azeedanhilmiya-eng/mine-safety-system/docs/README.md

# Project documents

## Project plans and experiments

- `project/矿山安全监测项目_华北五省比赛创新实施方案.docx` — competition implementation plan.
- `project/矿山安全监测系统_轻量离线语音识别与LoRa通信小步创新方案.docx` — offline voice and LoRa design proposal.
- `project/矿山安全监测系统_双节点语音与LoRa通信实施方案.docx` — dual-node implementation plan.
- `project/实验方案_离线语音与LoRa矿山安全监测.md` — experiment methods, target metrics, and data-recording templates.

The plans describe proposed work. Target metrics and unfilled schedules are not test results.

## Hardware files

- `hardware/最新方案_硬件清单.md` and `hardware/最新方案_硬件采购与PCB核对清单.xlsx` — component selection and PCB compatibility notes.
- `hardware/Gerber_safety-system_PCB_safety-system_2026-04-22(3).zip` — PCB manufacturing files.

For firmware layout and build instructions, see [`../firmware/README.md`](../firmware/README.md).
