azeedanhilmiya-eng/mine-safety-system/docs/project/矿山安全监测项目_华北五省比赛创新实施方案.docx

矿山安全监测项目
华北五省比赛创新实施方案

在现有系统基础上增加轻量趋势预警与可靠通信

参赛方向

本科组 方向三 具身智能与物理 AI

2026 年 9 月

# 一 总体结论

本方案坚持少改硬件、少加功能、先做完整。保留现有两套井下节点、地面网关、LoRa、OLED、短信和 App，只完成一个小创新和两项必要优化：在地面网关增加轻量趋势预警，统一设备与 App 数据字段，为 LoRa 增加序号和一次重传。完成后即可形成适合本科课程设计的监测、预警、告警和展示闭环。

# 二 赛道定位与比赛硬要求

- 参赛方向：本科组方向三“具身智能与物理 AI”。现有 ESP32-S3、LoRa、传感器、声光告警和实体终端与该方向匹配度较高。
- 作品须提供可运行的完整软硬件系统、详细设计文档、源代码和实物作品，并准备现场演示。
- 联网功能应按大赛要求通过公网正常访问；本地离线链路是增强系统鲁棒性和现场演示可靠性的设计，不替代公网访问要求。
- 作品必须原创。AI 辅助内容、第三方开源代码、模型名称和版本、AI 编写代码比例均需如实说明。
- 本科组每队 2—5 名学生，每人限参加一个团队；每队指导教师不超过 2 人。

# 三 建议作品名称

矿安智联 基于 ESP32 S3 和 LoRa 的端侧多灾害融合预警系统

# 四 现有项目基础

现有项目已经形成两套井下采集节点、一套地面网关、LoRa 传输、OLED 与声光报警、SIM800L 短信、Firebase、Web 看板和 Flutter 应用，主体功能已经足够。比赛版不重新设计 PCB，不增加摄像头、机械臂或大量传感器，也不重做整套 App；只修通现有链路，并加入一个能够现场说明、现场演示和现场测量的小创新。

# 五 精简后的改造重点

当前情况 | 比赛版整改
固定 ADC 阈值判断 | 增加基于滑动均值和变化斜率的轻量趋势预警，硬阈值继续负责正式告警。
原始 ADC 值被标为 ppm | 完成标准标定后才能使用 ppm；否则统一称为相对浓度指数。
固件只发送 flags，App 读取 hazard_ch4 等字段 | 统一设备报文、数据库字段和 App 数据模型。
固件写 RTDB，部分程序读取 Firestore | 比赛版统一使用 RTDB，暂不迁移数据库。
实物 2 个节点，界面固定显示 3 个 | 节点数量配置化，所有界面和演示以真实硬件为准。
仍有国外坐标、电话和英文场景 | 全部替换为中国矿山试验场景和中文应急流程。
多份固件引脚定义不一致 | 按手中实物确定一份可用引脚表和主固件，其余副本暂不使用。

# 六 我们的小步创新方案

我们保留原有系统结构，只在现有数据链路上增加容易完成、容易解释的功能。核心创新是轻量趋势预警，两项配套优化是数据统一和 LoRa 简单重传。三项工作互相支撑，但都不需要新增复杂硬件。

改造项 | 具体做法 | 最低完成标准
小创新 轻量趋势预警 | 网关保存最近 10 次数据，计算滑动均值和变化斜率；用逻辑回归或简单评分输出低、中、高风险 | 能比硬阈值提前数秒显示风险上升，且不会替代硬阈值告警
优化一 数据统一 | 确定一套 JSON 字段，固件、RTDB、Web 和 Flutter 使用相同名称 | 两个真实节点的数据和告警能在 App 中正确显示
优化二 可靠传输 | 报文增加节点 ID、序号和校验；告警包未收到 ACK 时重发一次 | 演示中能显示包序号，丢包后可完成一次补发
展示优化 | 界面中文化，只显示两个节点、风险等级、通信状态和最近告警 | 五分钟内能完整演示正常监测、趋势预警和阈值告警
实验记录 | 用电位器或历史数据回放模拟缓慢上升和突增 | 完成阈值方案与趋势预警方案的简单对比表

- 必须完成：唯一主固件、统一字段、趋势预警、一次重传、中文界面和演示视频。
- 时间充足再做：本地网页、短信通知优化和更长时间稳定性测试。
- 本轮不做：新 PCB、摄像头、机械结构、复杂神经网络、多模型对比和真实危险气体实验。

# 七 目标系统架构

井下采集节点 → LoRa 传输 → 地面网关趋势预警 → Firebase 与现有 App

## 1 硬件与固件基线

- 保留 2 个 ESP32-S3 井下节点、SX1278 433 MHz LoRa、MQ-4、MQ-7、水浸传感器、地面 ESP32-S3、OLED、蜂鸣器和 SIM800L。
- 按真实 PCB 核对 ESP32-S3、LoRa、SIM800L、OLED 和告警器件引脚，只保留一份可编译主固件。
- 不新增传感器，不重画 PCB；SIM800L 若供电不稳定，可在比赛演示中降为可选功能。

## 2 轻量趋势预警

地面网关保存每个节点最近 10 次采样，计算 MQ-4、MQ-7 和水浸数据的滑动均值与变化斜率。首选逻辑回归；如果训练与部署来不及，可使用归一化加权评分实现同样的低、中、高风险输出，并如实说明算法。

- 缓慢上升时先显示“趋势风险”，达到原有阈值后再触发蜂鸣器和正式告警。
- 输入只使用已有传感器数据，不做图像识别、不做复杂神经网络，也不要求在每个井下节点重复部署。
- 课程设计重点是把采样、计算、显示和告警流程讲清楚，并通过几组安全故障注入证明趋势功能有效。

## 3 简化的可靠通信

- 报文保留节点 ID、序号、传感器值、风险等级和告警位；沿用现有 LoRa 参数。
- 普通数据定时发送，告警数据立即发送；告警包未收到 ACK 时只重发一次，避免实现复杂状态机。
- 地面网关继续同步 Firebase 和现有 App；断网时 OLED 与本地声光告警仍可工作。

# 八 数据采集和实验方案

本作品为教学与竞赛原型，未经矿用防爆、本安及计量认证，不用于真实井下安全生产。不得在宿舍或非专业场所使用危险浓度甲烷、一氧化碳开展测试。数据应由正常实测和安全故障注入两部分组成，并对模拟数据明确标注。

1. 正常数据：每个节点连续记录 30 分钟，覆盖传感器预热和稳定阶段。

2. 趋势数据：使用电位器、DAC 或历史数据回放，分别模拟缓慢上升、快速上升和恢复正常。

3. 每类场景重复 5 次，记录趋势提示时间、阈值告警时间和误提示次数，整理成一张对比表。

4. MQ 传感器未经标准气体标定时只报告相对浓度指数，不使用 ppm；不开展真实危险气体实验。

# 九 必须报告的指标

类别 | 指标 | 建议验收目标
趋势预警 | 提前量、正确提示次数、误提示次数 | 每类场景重复 5 次，结果如实报告
对比 | 固定阈值与趋势预警 | 展示缓慢上升场景中的平均提前量
端侧 | 单次计算时间、Flash、RAM | 不影响原有采样和通信
通信 | 接收率、一次重传成功率 | 两个节点各发送 300 包，接收率目标不低于 95%
告警 | 传感器输入变化到本地声光告警 | 定义起止时间与测试设备，目标小于 1 秒
稳定性 | 连续运行与断电重启 | 连续运行 4 小时并完成 3 次断电恢复

# 十 现场演示闭环

1. 展示两个真实节点在线、实时数据和通信质量。

2. 通过安全故障注入模拟数据缓慢上升，展示趋势风险由低变为中、高。

3. 继续升高输入，触发硬阈值声光告警，证明安全兜底。

4. 展示 LoRa 包序号和一次重传结果，再在 App 中查看同一节点的记录。

5. 用一张对比表说明趋势提示相对硬阈值告警的平均提前时间。

# 十一 推进时间表

日期 | 主要任务 | 阶段产物
9 月 7—10 日 | 核对引脚并确定唯一主固件，跑通双节点采样、LoRa、OLED 和硬阈值告警 | 引脚表、可编译固件、基线视频
9 月 11—16 日 | 统一 JSON、RTDB 和 App 字段，界面只显示两个真实节点 | 字段表、端到端数据截图
9 月 17—21 日 | 实现 10 点滑动均值、变化斜率和三级风险；增加包序号与一次重传 | 趋势预警代码、重传日志
9 月 22—27 日 | 每类场景重复 5 次，完成简单对比；中文化并准备报名 | 对比表、演示版；9 月 28 日前报名
9 月 28—10 月 2 日 | 完成 300 包通信测试、4 小时运行和 3 次断电恢复 | 通信与稳定性记录
10 月 3—6 日 | 使用官方模板整理文档、截图和视频，反复练习五分钟演示 | PDF、MP4、3 张截图
10 月 7 日 | 冻结代码、APK、PDF 和视频，模拟上传 | 最终提交包
10 月 8—10 日 | 正式提交并核对平台状态 | 提交回执和本地备份

# 十二 团队分工建议

角色 | 主要职责
嵌入式负责人 | 统一井下节点与网关固件，实现趋势计算、包序号和一次重传
硬件与测试负责人 | 核对引脚、传感器预热、故障注入、通信和稳定性测试
数据负责人 | 整理场景数据，计算趋势提示提前量和误提示次数
应用与材料负责人 | 统一 RTDB 与 Flutter 字段，完成中文化、文档、截图和视频

# 十三 最终提交清单

- 作品简介：3 张核心功能截图，每张不超过 1 MB；中文简介不超过 400 字。
- 软件创意设计文档：使用大赛官网模板，以 PDF 提交，包含需求、概要设计、详细设计、操作步骤、测试方法和结果。
- 完整源代码：标明团队原创、第三方开源和 AI 辅助部分，附编译与复现说明。
- Android 安装包：Flutter 跨平台作品按照 Android 项目要求提交 APK。
- 演示视频：MP4，不超过 5 分钟、150 MB。
- 现场实物：两个井下节点、地面网关、电源、手机或电脑、本地演示数据、备用线材和备用固件。

# 十四 五分钟视频结构

时间 | 内容
0:00—0:25 | 矿山安全痛点、目标用户和项目结论
0:25—0:55 | 完整实物、系统架构和数据流
0:55—2:05 | 正常监测、LoRa、OLED 和手机端
2:05—3:20 | 数据缓慢上升、趋势预警、硬阈值声光告警
3:20—3:55 | 包序号、一次重传和 App 数据同步
3:55—4:30 | 提前量、通信和稳定性测试结果
4:30—5:00 | 小步创新、课程设计收获和后续工作

# 十五 报名与决赛日期提示

拟定稿列出的节点为：9 月 28 日前报名，10 月 8—10 日提交作品，10 月 21 日前完成区赛评审。拟定稿写决赛答辩为 11 月 14 日，而截至 2026 年 9 月 6 日的大赛官网页面显示为 11 月 15 日，应以后续正式通知为准。

# 十六 项目组当前第一步

第一周只做基线，不碰新硬件：按真实 PCB 核对引脚，确定唯一可编译固件，完成两个井下节点和地面网关的烧录验收。确认采样、LoRa、OLED 和硬阈值告警稳定后，第二周统一 App 字段，第三周加入 10 点趋势预警与一次重传。若时间不足，优先保证趋势预警和完整演示，本地网页、短信优化等功能直接放到后续工作。
