azeedanhilmiya-eng/mine-safety-system/docs/hardware/最新方案_硬件清单.md

# 最新方案硬件采购清单

核查日期：2026-09-11。以9月9日的《轻量离线语音识别与LoRa通信小步创新方案》为基线：两个井下节点、一个地面网关，仅井下节点1增加INMP441和瞬时按键。

**当前可确认主体方案与关键孔距，但不能声称所有器件已实现原位兼容。** 原PCB的Q1、Q2、R1、R2、D1、C2尚缺完整原理图/BOM参数。表中明确列为待定。京东主要模块有商品记录；淘宝仅提供检索入口，未核验具体商品、库存或价格。

|编号|用途|硬件|数量|下单规格|PCB兼容要求|采购|证据状态|
|---|---|---|---:|---|---|---|---|
|01|主体|原版 safety-system PCB|3片|2井下+1地面。以本地2026-04-22 Gerber打样，板框约99.187×62.992 mm。|须按角色装配；尚未核完全部网络。双面FR-4、1.6 mm可作询价起点，非已知原版叠层。|[京东](https://search.jd.com/Search?keyword=PCB%E6%89%93%E6%A0%B7%20%E5%8F%8C%E9%9D%A2%20Gerber&enc=utf-8) / [淘宝](https://s.taobao.com/search?q=PCB%E6%89%93%E6%A0%B7%20%E5%8F%8C%E9%9D%A2%20Gerber)|定制打样，非现成商品；[依据](https://github.com/SanchilaAmavi/mine-safety-system)|
|02|主体|ESP32-S3 N16R8 开发板|3块|每侧22针，共44针；针距2.54 mm；两排中心距25.40 mm；16 MB Flash、8 MB PSRAM；双USB口外形。|核对全部针序。N16R8只说明内存，不能保证板型。不要买MINI、CAM或裸模组。|[京东](https://search.jd.com/Search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) / [淘宝](https://s.taobao.com/search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)|京东商品页；尺寸待卖家确认；[依据](https://ic-item.jd.com/10136137497839.html)|
|03|主体|Ra-02 SX1278 433 MHz模块|3块|SPI接口、3.3 V；配下面的2×8转接底板，选IPEX天线座版本。|不要以串口LoRa、E32、SX1262、Ra-02裸贴片直接替换整套插接组件。|[京东](https://search.jd.com/Search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) / [淘宝](https://s.taobao.com/search?q=%E5%AE%89%E4%BF%A1%E5%8F%AF%20Ra-02%20SX1278%20433MHz%20SPI%20%E6%A8%A1%E5%9D%97)|京东有相关组合商品记录；[依据](https://i-search.jd.com/search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)|
|04|主体|Ra-02 专用转接底板|3块|2×8针；针距2.54 mm；两排中心距25.40 mm。优先买已焊Ra-02的同款蓝色底板。|这是独立物料；若上一项买模块+底板组合，本项不要重复买。逐针核对SPI、DIO和电源。|[京东](https://search.jd.com/Search?keyword=Ra-02%20%E8%BD%AC%E6%8E%A5%E6%9D%BF%202.54%2016%E9%92%88%2025.4&enc=utf-8) / [淘宝](https://s.taobao.com/search?q=Ra-02%20%E8%BD%AC%E6%8E%A5%E6%9D%BF%202.54%2016%E9%92%88%2025.4)|京东有组合商品；尺寸待核；[依据](https://i-search.jd.com/search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)|
|05|主体|433 MHz天线|3套|匹配Ra-02 IPEX座。可选433MHz FPC天线，或IPEX转SMA馈线+433MHz胶棒天线。|每个LoRa节点一套。按连接器实物匹配，勿买2.4GHz天线。|[京东](https://search.jd.com/Search?keyword=433MHz%20IPEX%20%E5%A4%A9%E7%BA%BF%20Ra02&enc=utf-8) / [淘宝](https://s.taobao.com/search?q=433MHz%20IPEX%20%E5%A4%A9%E7%BA%BF%20Ra02)|京东组合商品含天线选项；[依据](https://i-search.jd.com/search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)|
|06|井下|MQ-4甲烷传感器模块|2块|每个井下节点1块。带VCC、GND、AO、DO的完整模块，使用AO。|通过4芯线按网络顺序连接；针距吻合不代表针序一致。5V供电时AO需保护。|[京东](https://search.jd.com/Search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) / [淘宝](https://s.taobao.com/search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)|京东商品集合含MQ-4；[依据](https://www.jd.com/jiage/17132b09fd5c257ce1a1.html)|
|07|井下|MQ-7一氧化碳传感器模块|2块|每个井下节点1块。带AO的完整模块，勿买单独气敏头或误选MQ-2。|按原方案做相对阈值演示；定量CO测量还需要相应型号规定的加热控制和标定。|[京东](https://search.jd.com/Search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) / [淘宝](https://s.taobao.com/search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)|京东商品集合含MQ-7；[依据](https://www.jd.com/jiage/17132b09fd5c257ce1a1.html)|
|08|井下|三针模拟水位传感器|2块|每节点1块。Water Sensor红色板，S/+/-三线，优先选支持3.3V供电的型号。|原固件analogRead，不能直接用只有开关量、RS485或4—20mA的产品替换。|[京东](https://search.jd.com/Search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) / [淘宝](https://s.taobao.com/search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)|京东商品集合含红板；[依据](https://www.jd.com/jiage/98556ba94db2ae3ea119.html?catID=33467)|
|09|井下|DC12V有源警号|2只|每节点1只。建议小型两线、通电即响、额定电流不超过0.3A。|经功率驱动级控制，不得接GPIO供电；核实负载电流后再定驱动元件。|[京东](https://search.jd.com/Search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) / [淘宝](https://s.taobao.com/search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)|京东有12V警号商品记录；[依据](https://www.jd.com/chanpin/2464620.html)|
|10|地面|1.3英寸SH1106 OLED|1块|128×64，I2C/IIC四针，支持3.3V逻辑。|选SH1106，勿误选SSD1306/7针SPI。原板左侧无名4针口需通断确认；可接线到GPIO5/6。|[京东](https://search.jd.com/Search?keyword=1.3%20OLED%20SH1106%20IIC%204%E9%92%88%2012864&enc=utf-8) / [淘宝](https://s.taobao.com/search?q=1.3%20OLED%20SH1106%20IIC%204%E9%92%88%2012864)|京东记录明确区分驱动和针序；[依据](https://www.jd.com/brand/6702ff6809be9acbc80.html)|
|11|地面|有源蜂鸣器驱动模块|1块|支持3.3V控制，优先高电平触发，带三极管驱动。|外接GPIO8/VCC/GND；若买低电平触发款需改固件。PCB未见明确蜂鸣器专用位置。|[京东](https://search.jd.com/Search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) / [淘宝](https://s.taobao.com/search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)|京东有蜂鸣器模块记录；触发极性待选；[依据](https://www.jd.com/chanpin/3111473.html)|
|12|语音新增|INMP441 I2S麦克风模块|1块|仅井下节点1安装。3.3V，带VDD/GND/SCK/WS/SD/LR引脚。|飞线外接。不要买MAX9814、模拟咪头或串口语音识别模块代替。|[京东](https://search.jd.com/Search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) / [淘宝](https://s.taobao.com/search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)|京东商品集合明确含INMP441；[依据](https://www.jd.com/hprm/99874b6301f92dc6870a.html)|
|13|语音新增|常开瞬时按键|1只|按下导通，松开断开；面板式带线或轻触按键小板。|外接空闲GPIO与GND，软件上拉。不要买自锁按钮作按住说话键。|[京东](https://search.jd.com/Search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) / [淘宝](https://s.taobao.com/search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)|检索入口，未核验具体商品|
|14|供电|12V 3A稳压电源适配器|3只|三节点各1只；低压DC输出，建议5.5×2.1 mm中心正极，配套相同插座。|本表选型余量，非原版标定功耗。最终核对警号、传感器和GSM峰值。|[京东](https://search.jd.com/Search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) / [淘宝](https://s.taobao.com/search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)|京东有12V3A适配器记录；[依据](https://www.jd.com/chanpin/2672192.html)|
|15|供电|LM2596S可调降压模块|3块|四电气焊孔中心形成约40.005×17.780 mm矩形；输出先调5.0V用于主板。|丝印虽写LM2596，实物示例可能是别种降压板。只认孔位和极性；XL4015不能默认直插。|[京东](https://search.jd.com/Search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) / [淘宝](https://s.taobao.com/search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)|京东有商品；孔位待确认；[依据](https://www.jd.com/jiage/9855bb3adf062efa6df1.html)|
|16|短信条件项|SIM800L小板|1块|地面网关用。原板标识一列GND/TX/RX/RST/VCC，针距2.54 mm；需逐脚对应。|购买前核实当地SIM卡能注册2G GSM并发短信。大号开发板不视为原位兼容。|[京东](https://search.jd.com/Search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) / [淘宝](https://s.taobao.com/search?q=SIM800L%20%E7%BA%A2%E6%9D%BF%20%E6%A8%A1%E5%9D%97%20RST%20VCC%20GSM)|京东商品页；未证实该SKU原位兼容；[依据](https://ic-item.jd.com/100079675820.html)|
|17|短信条件项|GSM天线|1套|匹配所购SIM800L的天线接口；GSM频段天线。|若模块已带天线无需重复购买，不能用LoRa天线代替。|[京东](https://search.jd.com/Search?keyword=SIM800L%20GSM%20%E5%A4%A9%E7%BA%BF&enc=utf-8) / [淘宝](https://s.taobao.com/search?q=SIM800L%20GSM%20%E5%A4%A9%E7%BA%BF)|京东商品含配天线版本；[依据](https://ic-item.jd.com/100079675820.html)|
|18|短信条件项|可发短信的SIM卡|1张|卡尺寸匹配SIM800L卡座，并已开通短信、可接入当地2G GSM网络。|覆盖和开通状态未核验。仅流量物联网卡不等于可发短信。|[京东](https://search.jd.com/Search?keyword=GSM%20%E7%9F%AD%E4%BF%A1%20SIM%E5%8D%A1&enc=utf-8) / [淘宝](https://s.taobao.com/search?q=GSM%20%E7%9F%AD%E4%BF%A1%20SIM%E5%8D%A1)|检索入口，未核验具体商品|
|19|短信条件项|SIM800L独立降压电源|1块|以裸芯片供电版为前提：可调约4.0V，供电系统可承受2A发射峰值，建议留3A级余量。|外接供电。核实小板是否自带稳压，禁止把4V和5V电源并联到同一VCC网络。|[京东](https://search.jd.com/Search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) / [淘宝](https://s.taobao.com/search?q=XL4015%20%E5%8F%AF%E8%B0%83%E9%99%8D%E5%8E%8B%205A%20%E6%A8%A1%E5%9D%97)|京东有XL4015记录；作为外接电源；[依据](https://www.jd.com/jiage/9855bb3adf062efa6df1.html)|
|20|短信条件项|UART电平匹配小板|1块|选适用于UART推挽信号、3.3V与SIM800L约2.8V逻辑匹配的方案。|先核实SIM800L小板已否集成。不要将I2C专用转换模块默认视为验证通过。|[京东](https://search.jd.com/Search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) / [淘宝](https://s.taobao.com/search?q=UART%20%E4%B8%B2%E5%8F%A3%203.3V%202.8V%20%E7%94%B5%E5%B9%B3%E8%BD%AC%E6%8D%A2)|检索入口，未核验具体商品|
|21|接口保护|10kΩ 1%电阻|10只|4路MQ AO各1只上臂电阻，余6只备用；1/4W直插便于小板焊接。|用于外加分压，不是原PCB的R1/R2指定值。|[京东](https://search.jd.com/Search?keyword=10K%20%E7%94%B5%E9%98%BB%201%25%201%2F4W&enc=utf-8) / [淘宝](https://s.taobao.com/search?q=10K%20%E7%94%B5%E9%98%BB%201%25%201%2F4W)|检索入口，未核验具体商品|
|22|接口保护|15kΩ 1%电阻|10只|4路MQ AO各1只下臂电阻，余6只备用；5V经10k/15k分压约3.0V。|分压接法AO—10k—ADC，ADC—15k—GND。先确认原板有无分压，再接入。|[京东](https://search.jd.com/Search?keyword=15K%20%E7%94%B5%E9%98%BB%201%25%201%2F4W&enc=utf-8) / [淘宝](https://s.taobao.com/search?q=15K%20%E7%94%B5%E9%98%BB%201%25%201%2F4W)|检索入口，未核验具体商品|
|23|接口保护|100nF去耦/滤波电容|10只|4只可用于ADC端对地滤波，1只麦克风近端去耦，其余备用。|外接小板按需要装配；增加分压后需重新设传感阈值。|[京东](https://search.jd.com/Search?keyword=100nF%20104%20%E7%8B%AC%E7%9F%B3%20%E7%94%B5%E5%AE%B9&enc=utf-8) / [淘宝](https://s.taobao.com/search?q=100nF%20104%20%E7%8B%AC%E7%9F%B3%20%E7%94%B5%E5%AE%B9)|检索入口，未核验具体商品|
|24|接口保护|10µF去耦电容|5只|耐压≥10V；麦克风/低压辅助电路局部去耦，含备用。|此项为外接辅助器件，不是原PCB C2已确认容量。|[京东](https://search.jd.com/Search?keyword=10uF%2016V%20%E7%94%B5%E5%AE%B9&enc=utf-8) / [淘宝](https://s.taobao.com/search?q=10uF%2016V%20%E7%94%B5%E5%AE%B9)|检索入口，未核验具体商品|
|25|短信条件项|低ESR储能电容|2只|暂选470—1000µF、≥10V，GSM电源近端1只加备用1只。|为辅助供电建议，不代替电源峰值能力，也不是已确认的原板C2值。|[京东](https://search.jd.com/Search?keyword=1000uF%2010V%20%E4%BD%8EESR%20%E7%94%B5%E5%AE%B9&enc=utf-8) / [淘宝](https://s.taobao.com/search?q=1000uF%2010V%20%E4%BD%8EESR%20%E7%94%B5%E5%AE%B9)|检索入口，未核验具体商品|
|26|接插件|2.54 mm 1×22排母|6条|每块主板2条，共6条。|配ESP32-S3。井下语音板可选带引出焊点/长脚方案便于飞线，避免双层插座松动。|[京东](https://search.jd.com/Search?keyword=2.54%20%E5%8D%95%E6%8E%92%20%E6%8E%92%E6%AF%8D%2022P&enc=utf-8) / [淘宝](https://s.taobao.com/search?q=2.54%20%E5%8D%95%E6%8E%92%20%E6%8E%92%E6%AF%8D%2022P)|检索入口，未核验具体商品|
|27|接插件|2.54 mm 1×8排母|6条|每块主板2条，共6条。|配Ra-02转接板，注意方向。|[京东](https://search.jd.com/Search?keyword=2.54%20%E5%8D%95%E6%8E%92%20%E6%8E%92%E6%AF%8D%208P&enc=utf-8) / [淘宝](https://s.taobao.com/search?q=2.54%20%E5%8D%95%E6%8E%92%20%E6%8E%92%E6%AF%8D%208P)|检索入口，未核验具体商品|
|28|接插件|2.54 mm 1×40排针/排母|4组|建议2组排针+2组排母，用于可裁剪接口及备用。|已焊针模块不要重复计算模块针。|[京东](https://search.jd.com/Search?keyword=2.54%20%E6%8E%92%E9%92%88%20%E6%8E%92%E6%AF%8D%2040P&enc=utf-8) / [淘宝](https://s.taobao.com/search?q=2.54%20%E6%8E%92%E9%92%88%20%E6%8E%92%E6%AF%8D%2040P)|检索入口，未核验具体商品|
|29|接插件|4P板端座和4芯线|5套|MQ4/MQ7共4套，地面显示1套；本地相应孔距约2.54 mm。|优先按2.54 mm规格询价。XH2.54、XH2.5商品命名混乱，须看机械图。针序可重排。|[京东](https://search.jd.com/Search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) / [淘宝](https://s.taobao.com/search?q=2.54%204P%20%E8%BF%9E%E6%8E%A5%E5%99%A8%20%E5%BA%A7%20%E5%B8%A6%E7%BA%BF)|检索入口，未核验具体商品|
|30|接插件|3P板端座和3芯线|2套|两个水位接口，针距2.54 mm。|每套含板端座及带端子的线束，按S/+/-重排。|[京东](https://search.jd.com/Search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) / [淘宝](https://s.taobao.com/search?q=2.54%203P%20%E8%BF%9E%E6%8E%A5%E5%99%A8%20%E5%BA%A7%20%E5%B8%A6%E7%BA%BF)|检索入口，未核验具体商品|
|31|接插件|DC电源插座P1|3只|Gerber显示三孔近似共线，中心距约5.00 mm。接口内径按电源插头配套。|不能凭DC-005/DC-022名称下单。先让卖家提供脚位图，或外接带线DC座。|[京东](https://search.jd.com/Search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) / [淘宝](https://s.taobao.com/search?q=DC%20%E7%94%B5%E6%BA%90%E6%8F%92%E5%BA%A7%20%E4%B8%89%E8%84%9A%205.5%202.1)|检索入口，未核验具体商品|
|32|接插件|6脚双刀开关SWITCH|3只|2×3焊脚，单列相邻孔距2.50 mm，两列中心距5.50 mm。|选择保持型电源开关，核实端子额定电流和通断逻辑；与语音瞬时按键不同。|[京东](https://search.jd.com/Search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) / [淘宝](https://s.taobao.com/search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)|检索入口，未核验具体商品|
|33|接插件|警号2P接线端子|2只|本地SIREN两孔中心距6.35 mm。|不要默认买5.08 mm端子，若无合适外形可用可靠焊线并做应力固定。|[京东](https://search.jd.com/Search?keyword=%E6%8E%A5%E7%BA%BF%E7%AB%AF%E5%AD%90%202P%206.35mm&enc=utf-8) / [淘宝](https://s.taobao.com/search?q=%E6%8E%A5%E7%BA%BF%E7%AB%AF%E5%AD%90%202P%206.35mm)|检索入口，未核验具体商品|
|34|接插件|杜邦线和硅胶电源线|1批|2.54mm公母/母母信号线；电源与警号另用较粗多股线，GSM电源线尽量短。|麦克风线尽量短。不要用细杜邦线承载GSM峰值和警号负载。|[京东](https://search.jd.com/Search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) / [淘宝](https://s.taobao.com/search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)|检索入口，未核验具体商品|
|35|装配|2.54 mm洞洞板|2块|接口分压/按键/电平转换等外接小电路。|不改原PCB布线，但新增外接电路需要独立固定。|[京东](https://search.jd.com/Search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) / [淘宝](https://s.taobao.com/search?q=2.54%20%E6%B4%9E%E6%B4%9E%E6%9D%BF%20%E4%B8%87%E8%83%BD%E6%9D%BF)|检索入口，未核验具体商品|
|36|装配|绝缘外壳|3只|选内尺寸能容纳约99.2×63.0 mm主板及高件，建议从120×90×60 mm内空间询价。|尺寸为布置建议。预留USB、天线、传感器通气、麦克风声孔、OLED窗口。|[京东](https://search.jd.com/Search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) / [淘宝](https://s.taobao.com/search?q=ABS%20%E7%94%B5%E5%AD%90%E9%A1%B9%E7%9B%AE%E7%9B%92%20%E5%A4%96%E5%A3%B3)|检索入口，未核验具体商品|
|37|装配|绝缘固定件和辅材|1批|尼龙支撑/PCB卡槽、螺钉螺母、热缩管、扎带、标签、绝缘垫。|原板未确认标准M3安装孔，不能直接假定铜柱穿板可用；按外壳固定结构购买。|[京东](https://search.jd.com/Search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) / [淘宝](https://s.taobao.com/search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)|检索入口，未核验具体商品|
|38|调试|USB数据线|3根|匹配所选开发板接口，可传数据。|USB与外部电源同时使用前确认开发板电源隔离，避免回灌。|[京东](https://search.jd.com/Search?keyword=Type%20C%20USB%20%E6%95%B0%E6%8D%AE%E7%BA%BF&enc=utf-8) / [淘宝](https://s.taobao.com/search?q=Type%20C%20USB%20%E6%95%B0%E6%8D%AE%E7%BA%BF)|检索入口，未核验具体商品|
|39|待定原位|Q1三极管|2只|井下驱动位每板1只。外形类似TO-92，型号和E/B/C网络未确认。|暂停按型号购买；Gerber丝印不能推断S8050、2N2222或其引脚排列。|型号待定|缺原理图/BOM，不可按占位词采购；[依据](https://github.com/SanchilaAmavi/mine-safety-system)|
|40|待定原位|Q2功率管|2只|井下驱动位每板1只。外形类似TO-220，孔距2.54 mm；器件类型/型号未确认。|先确定栅极/源极/漏极网络、极性及驱动电压，不能直接指定IRF540或IRLZ44N。|型号待定|缺原理图/BOM，不可按占位词采购；[依据](https://github.com/SanchilaAmavi/mine-safety-system)|
|41|待定原位|R1、R2驱动电阻|4只|两个井下板各R1/R2一只，共4只。阻值、功率及装配方式未确认。|不可拿外接分压的10k/15k直接代替。|型号待定|缺原理图/BOM，不可按占位词采购；[依据](https://github.com/SanchilaAmavi/mine-safety-system)|
|42|待定原位|D1二极管|2只|井下板各1只。封装、极性、用途及耐压电流均待确认。|不能仅凭D1假定是1N4007、SS34或稳压二极管。|型号待定|缺原理图/BOM，不可按占位词采购；[依据](https://github.com/SanchilaAmavi/mine-safety-system)|
|43|待定原位|C2电解电容|3只|每板1个位置，孔中心距5.08 mm。容量、耐压和所在电源网络未确认。|若在12V轨，16V仅是耐压起点，优先核对原设计。不要把GSM近端电容默认焊此处。|型号待定|缺原理图/BOM，不可按占位词采购；[依据](https://github.com/SanchilaAmavi/mine-safety-system)|
|44|备选外接|3.3V触发MOS开关模块|2块|仅在无法确定原驱动级时作为外接替代路径，控制12V警号，支持高电平触发。|与Q1/Q2/R1/R2/D1原位装配二选一。须验证GPIO18触发和断电状态，不算原位兼容。|[京东](https://search.jd.com/Search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) / [淘宝](https://s.taobao.com/search?q=MOS%20%E5%BC%80%E5%85%B3%E6%A8%A1%E5%9D%97%203.3V%20%E8%A7%A6%E5%8F%91%2012V)|京东有同类记录；控制门限待核；[依据](https://www.jd.com/chanpin/3111473.html)|
|45|备件|关键模块备件|1批|可另备ESP32-S3×1、Ra-02+底板+天线×1、INMP441×1。|选配，未计入上方装机数量。已有可用硬件按实际抵扣，文件存在不等于实物已持有。|[京东](https://search.jd.com/Search?keyword=ESP32%20S3%20N16R8%20Ra02%20INMP441&enc=utf-8) / [淘宝](https://s.taobao.com/search?q=ESP32%20S3%20N16R8%20Ra02%20INMP441)|检索入口，未核验具体商品|
|46|工具|万用表及焊接工具|1套|万用表、恒温焊台、焊锡/助焊剂、吸锡带、镊子、剥线钳。|已有可借用。上电前测各电源轨电压和对地短路。|[京东](https://search.jd.com/Search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) / [淘宝](https://s.taobao.com/search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)|检索入口，未核验具体商品|
|47|演示已有|电脑、手机和2.4GHz网络|1套|训练/烧录电脑、App演示手机，可用手机热点；断网演示本身不需路由器。|默认复用。离线关键词识别不需树莓派、摄像头、功放或语音播放扬声器。|[京东](https://search.jd.com/Search?keyword=2.4GHz%20WiFi%20%E8%B7%AF%E7%94%B1%E5%99%A8&enc=utf-8) / [淘宝](https://s.taobao.com/search?q=2.4GHz%20WiFi%20%E8%B7%AF%E7%94%B1%E5%99%A8)|检索入口，未核验具体商品|

## PCB核对说明

- **方案基线：9月9日离线语音方案**。两套井下节点+一套地面网关。只给井下节点1增加INMP441和瞬时按键。（依据：本地最新方案及build_competition_plan.py）
- **核验范围：尚非逐器件定版BOM**。本次已核对原仓库、固件、实物照片和Gerber钻孔。无完整原理图/BOM，未做实板通断或全网表还原。（依据：GitHub README和本地Gerber）
- **采购证据：商品记录不等于库存确认**。京东主要模块查到商品页或集合记录；链接未证明具体SKU的尺寸、电气兼容或收货地库存。淘宝仅提供检索入口。（依据：2026-09-11检索）
- **PCB外形：99.187 × 62.992 mm**。板框X=9.271至108.458，Y=-35.052至27.940。板厚和铜厚未从Gerber证实。（依据：Gerber_BoardOutlineLayer.GKO）
- **ESP32插座：2×22；2.54 mm；排距25.40 mm**。两排Y=19.431和-5.969。每排X=52.832至106.172。要求完整开发板按此针序布置。（依据：Drill_PTH_Through.DRL，T03）
- **ESP32针序：从天线端到USB端核对**。3V3侧：3V3,3V3,RST,4,5,6,7,15,16,17,18,8,3,46,9,10,11,12,13,14,5V,GND。另一侧：GND,TX,RX,1,2,42,41,40,39,38,37,36,35,0,45,48,47,21,20,19,GND,GND。（依据：Gerber_TopSilkscreenLayer.GTO和原板照片）
- **LoRa底板：2×8；2.54 mm；排距25.40 mm**。两列X=73.787和99.187；Y=-12.954至-30.734。必须带转接板，针序另核。（依据：Drill_PTH_Through.DRL，T04）
- **降压板：焊孔矩形40.005 × 17.780 mm**。X=25.273/65.278，Y=-13.081/-30.861；按丝印IN+/IN-/OUT+/OUT-核对。孔位不是板外形尺寸。（依据：Drill_PTH_Through.DRL，T04）
- **警号端子：6.35 mm**。X=22.860和29.210，Y=22.733。可按孔距买端子，外形仍需匹配。（依据：Drill_PTH_Through.DRL，T09）
- **电源开关：单列2.50 mm；两列5.50 mm**。2×3脚。X=11.982/17.482，Y=-31.202/-28.702/-26.202；检查开关内部连接。（依据：Drill_PTH_Through.DRL，T05）
- **P1/C2：P1约5.00 mm；C2为5.08 mm**。P1三孔近共线；C2两孔X=37.719/42.799。仅能约束机械尺寸，不能给出DC座具体型号或电容值。（依据：Drill_PTH_Through.DRL，T10/T05）
- **原驱动级：Q1/Q2/R1/R2/D1待定**。严格原位装配需要作者的原理图或BOM；外接MOS驱动是另外一条实现路径，不能冒称原版元件。（依据：原板丝印和assembled pcb.jpg）
- **电源路径：12V、5V、3.3V、约4V分开**。12V供警号，主降压5V供ESP32开发板及适配的MQ模块，Ra-02/INMP441用3.3V。SIM800L按小板说明独立供电。（依据：原方案；安信可Ra-02；SIMCom供电文档）
- **模拟输入保护：四路MQ AO先核电压**。10k上臂+15k下臂使5V约变3.0V；需外接改线且重新标定阈值。若原板已有合适分压不叠加。5V供电水位模块也须同样核验输出上限。（依据：原固件GPIO4/5/6为ADC输入；工程补充选型）
- **语音飞线建议：GPIO15/16/17及GPIO7**。候选映射：SCK=15，WS=16，SD=17，按键=7。仅根据现有井下固件未占用提出，须测原板网络后确定；LR接GND选单声道。（依据：underground_node1_mine1.ino；INMP441模块引脚需实物核对）
- **已占用引脚：LoRa与传感器保持一致**。LoRa NSS10/MOSI11/SCK12/MISO13/RST14/DIO0=9；井下MQ4=4/MQ7=5/水位6/警号18；地面OLED5/6、蜂鸣器8、GSM47/48/19。（依据：本地firmware的两个节点文件）
- **地面USB冲突：GSM_RST=19需核对**。ESP32-S3 GPIO19涉及原生USB D-，如使用原生USB口需检查冲突，优先用独立USB-UART口调试。GPIO35/36/37也不作为N16R8语音接线默认选择。（依据：现有固件；ESP32-S3开发板资料）
- **SIM800L使用条件：网络及供电均待验证**。裸SIM800L典型供电3.4—4.4V、推荐4.0V并有约2A脉冲需求。成品小板可能自带稳压。2G注册/短信能力须在比赛地点实测。（依据：SIMCom SIM800H&SIM800L Hardware Design V2.02）
- **MQ-7局限：演示阈值不能当可靠ppm**。实际气敏元件的加热周期按厂家型号资料实施。MQ-7B资料给出高温60秒、低温90秒，不能默认所有廉价模块已实现。（依据：https://www.winsen-sensor.com/product/mq-7b.html?trk=public_post-text）
- **采购范围：教学和竞赛原型**。沿用最新方案的实验室用途；本清单不构成真实矿井使用的认证设备选型。（依据：最新本地方案第八节）
- **向卖家发送：开发板机械核对**。请确认ESP32-S3 N16R8是44针双USB板，每排22针、间距2.54mm、两排中心距25.40mm，并发正反面高清图及尺寸图。（依据：可复制询价文本）
- **向卖家发送：LoRa和电源板机械核对**。请确认Ra-02带16针转接板，每侧8针、两排中心距25.40mm；降压板四焊孔中心矩形40.005×17.780mm，并提供引脚图。（依据：可复制询价文本）

## 原始资料

- [GitHub原项目](https://github.com/SanchilaAmavi/mine-safety-system)
- [安信可Ra-02官方资料](https://docs.aithinker.com/Ra-02/)
- [SIMCom硬件设计手册镜像](https://www.electrokit.com/upload/product/41018/41018214/SIM800L-SIMCom.pdf)
- [INMP441厂家资料](https://product.tdk.cn/system/files/dam/doc/product/sw_piezo/mic/mems-mic/data_sheet/inmp441.pdf)

上述厂家PDF本次搜索可定位，但页面解析失败，具体模块仍以卖家提供的相应版本资料为准。
