azeedanhilmiya-eng/mine-safety-system/docs/hardware/最新方案_硬件采购与PCB核对清单.xlsx

Sheet: 采购清单
矿山安全监测系统硬件采购清单
范围：2个井下节点 + 1个地面网关 + 1套离线语音输入。方案版本2026-09-09，核查日期2026-09-11。
重要：Q1/Q2/R1/R2/D1/C2缺原理图参数，不能直接按型号采购；详见“待定原位”和“PCB核对”。
采购入口用于检索，不代表选定SKU或现货。京东有主要模块商品记录；淘宝商品页和库存未核验。
数量为完整原型需求；短信条件项、备选外接、备件、工具按需选择。未核实成交价，不虚列预算。
编号 | 用途 | 硬件名称 | 数量 | 单位 | 下单规格 | PCB兼容性 / 接线要求 | 京东淘宝搜索词 | 京东搜索 | 淘宝搜索 | 采购核验状态 | 已查到的证据 / 依据
01 | 主体 | 原版 safety-system PCB | 3 | 片 | 2井下+1地面。以本地2026-04-22 Gerber打样，板框约99.187×62.992 mm。 | 须按角色装配；尚未核完全部网络。双面FR-4、1.6 mm可作询价起点，非已知原版叠层。 | PCB打样 双面 Gerber | HYPERLINK is not implemented. linkLocation=https://search.jd.com/Search?keyword=PCB%E6%89%93%E6%A0%B7%20%E5%8F%8C%E9%9D%A2%20Gerber&enc=utf-8, friendlyName=京东检索 | HYPERLINK is not implemented. linkLocation=https://s.taobao.com/search?q=PCB%E6%89%93%E6%A0%B7%20%E5%8F%8C%E9%9D%A2%20Gerber, friendlyName=淘宝检索 | 定制打样，非现成商品 | https://github.com/SanchilaAmavi/mine-safety-system
02 | 主体 | ESP32-S3 N16R8 开发板 | 3 | 块 | 每侧22针，共44针；针距2.54 mm；两排中心距25.40 mm；16 MB Flash、8 MB PSRAM；双USB口外形。 | 核对全部针序。N16R8只说明内存，不能保证板型。不要买MINI、CAM或裸模组。 | ESP32 S3 N16R8 44针 双Type C 开发板 | HYPERLINK is not implemented. linkLocation=https://search.jd.com/Search?enc=utf-8, friendlyName=京东检索 | HYPERLINK is not implemented. linkLocation=https://s.taobao.com/search friendlyName=淘宝检索 | 京东商品页；尺寸待卖家确认 | https://ic-item.jd.com/10136137497839.html
03 | 主体 | Ra-02 SX1278 433 MHz模块 | 3 | 块 | SPI接口、3.3 V；配下面的2×8转接底板，选IPEX天线座版本。 | 不要以串口LoRa、E32、SX1262、Ra-02裸贴片直接替换整套插接组件。 | 安信可 Ra-02 SX1278 433MHz SPI 模块 | HYPERLINK is not implemented. linkLocation=https://search.jd.com/Search?enc=utf-8, friendlyName=京东检索 | HYPERLINK is not implemented. linkLocation=https://s.taobao.com/search friendlyName=淘宝检索 | 京东有相关组合商品记录 | https://i-search.jd.com/search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
04 | 主体 | Ra-02 专用转接底板 | 3 | 块 | 2×8针；针距2.54 mm；两排中心距25.40 mm。优先买已焊Ra-02的同款蓝色底板。 | 这是独立物料；若上一项买模块+底板组合，本项不要重复买。逐针核对SPI、DIO和电源。 | Ra-02 转接板 2.54 16针 25.4 | HYPERLINK is not implemented. linkLocation=https://search.jd.com/Search?enc=utf-8, friendlyName=京东检索 | HYPERLINK is not implemented. linkLocation=https://s.taobao.com/search?q=Ra-02%20%E8%BD%AC%E6%8E%A5%E6%9D%BF%202.54%2016%E9%92%88%2025.4, friendlyName=淘宝检索 | 京东有组合商品；尺寸待核 | https://i-search.jd.com/search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
05 | 主体 | 433 MHz天线 | 3 | 套 | 匹配Ra-02 IPEX座。可选433MHz FPC天线，或IPEX转SMA馈线+433MHz胶棒天线。 | 每个LoRa节点一套。按连接器实物匹配，勿买2.4GHz天线。 | 433MHz IPEX 天线 Ra02 | HYPERLINK is not implemented. linkLocation=https://search.jd.com/Search?keyword=433MHz%20IPEX%20%E5%A4%A9%E7%BA%BF%20Ra02&enc=utf-8, friendlyName=京东检索 | HYPERLINK is not implemented. linkLocation=https://s.taobao.com/search?q=433MHz%20IPEX%20%E5%A4%A9%E7%BA%BF%20Ra02, friendlyName=淘宝检索 | 京东组合商品含天线选项 | https://i-search.jd.com/search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
06 | 井下 | MQ-4甲烷传感器模块 | 2 | 块 | 每个井下节点1块。带VCC、GND、AO、DO的完整模块，使用AO。 | 通过4芯线按网络顺序连接；针距吻合不代表针序一致。5V供电时AO需保护。 | MQ-4 甲烷 传感器 模块 AO DO | HYPERLINK is not implemented. linkLocation=https://search.jd.com/Search?enc=utf-8, friendlyName=京东检索 | HYPERLINK is not implemented. linkLocation=https://s.taobao.com/search friendlyName=淘宝检索 | 京东商品集合含MQ-4 | https://www.jd.com/jiage/17132b09fd5c257ce1a1.html
07 | 井下 | MQ-7一氧化碳传感器模块 | 2 | 块 | 每个井下节点1块。带AO的完整模块，勿买单独气敏头或误选MQ-2。 | 按原方案做相对阈值演示；定量CO测量还需要相应型号规定的加热控制和标定。 | MQ-7 一氧化碳 传感器 模块 AO | HYPERLINK is not implemented. linkLocation=https://search.jd.com/Search?enc=utf-8, friendlyName=京东检索 | HYPERLINK is not implemented. linkLocation=https://s.taobao.com/search friendlyName=淘宝检索 | 京东商品集合含MQ-7 | https://www.jd.com/jiage/17132b09fd5c257ce1a1.html
08 | 井下 | 三针模拟水位传感器 | 2 | 块 | 每节点1块。Water Sensor红色板，S/+/-三线，优先选支持3.3V供电的型号。 | 原固件analogRead，不能直接用只有开关量、RS485或4—20mA的产品替换。 | 水位传感器 红板 Water Sensor 三针 模拟 | HYPERLINK is not implemented. linkLocation=https://search.jd.com/Search?enc=utf-8, friendlyName=京东检索 | HYPERLINK is not implemented. linkLocation=https://s.taobao.com/search friendlyName=淘宝检索 | 京东商品集合含红板 | https://www.jd.com/jiage/98556ba94db2ae3ea119.html?catID=33467
09 | 井下 | DC12V有源警号 | 2 | 只 | 每节点1只。建议小型两线、通电即响、额定电流不超过0.3A。 | 经功率驱动级控制，不得接GPIO供电；核实负载电流后再定驱动元件。 | 12V 有源警号 两线 小型 | HYPERLINK is not implemented. linkLocation=https://search.jd.com/Search?enc=utf-8, friendlyName=京东检索 | HYPERLINK is not implemented. linkLocation=https://s.taobao.com/search friendlyName=淘宝检索 | 京东有12V警号商品记录 | https://www.jd.com/chanpin/2464620.html
10 | 地面 | 1.3英寸SH1106 OLED | 1 | 块 | 128×64，I2C/IIC四针，支持3.3V逻辑。 | 选SH1106，勿误选SSD1306/7针SPI。原板左侧无名4针口需通断确认；可接线到GPIO5/6。 | 1.3 OLED SH1106 IIC 4针 12864 | HYPERLINK is not implemented. linkLocation=https://search.jd.com/Search?keyword=1.3%20OLED%20SH1106%20IIC%204%E9%92%88%2012864&enc=utf-8, friendlyName=京东检索 | HYPERLINK is not implemented. linkLocation=https://s.taobao.com/search?q=1.3%20OLED%20SH1106%20IIC%204%E9%92%88%2012864, friendlyName=淘宝检索 | 京东记录明确区分驱动和针序 | https://www.jd.com/brand/6702ff6809be9acbc80.html
11 | 地面 | 有源蜂鸣器驱动模块 | 1 | 块 | 支持3.3V控制，优先高电平触发，带三极管驱动。 | 外接GPIO8/VCC/GND；若买低电平触发款需改固件。PCB未见明确蜂鸣器专用位置。 | 有源蜂鸣器 模块 3.3V 高电平 触发 | HYPERLINK is not implemented. linkLocation=https://search.jd.com/Search?enc=utf-8, friendlyName=京东检索 | HYPERLINK is not implemented. linkLocation=https://s.taobao.com/search friendlyName=淘宝检索 | 京东有蜂鸣器模块记录；触发极性待选 | https://www.jd.com/chanpin/3111473.html
12 | 语音新增 | INMP441 I2S麦克风模块 | 1 | 块 | 仅井下节点1安装。3.3V，带VDD/GND/SCK/WS/SD/LR引脚。 | 飞线外接。不要买MAX9814、模拟咪头或串口语音识别模块代替。 | INMP441 I2S 数字麦克风 模块 | HYPERLINK is not implemented. linkLocation=https://search.jd.com/Search?enc=utf-8, friendlyName=京东检索 | HYPERLINK is not implemented. linkLocation=https://s.taobao.com/search friendlyName=淘宝检索 | 京东商品集合明确含INMP441 | https://www.jd.com/hprm/99874b6301f92dc6870a.html
13 | 语音新增 | 常开瞬时按键 | 1 | 只 | 按下导通，松开断开；面板式带线或轻触按键小板。 | 外接空闲GPIO与GND，软件上拉。不要买自锁按钮作按住说话键。 | 常开 瞬时 按钮开关 带线 | HYPERLINK is not implemented. linkLocation=https://search.jd.com/Search?enc=utf-8, friendlyName=京东检索 | HYPERLINK is not implemented. linkLocation=https://s.taobao.com/search friendlyName=淘宝检索 | 检索入口，未核验具体商品 | 通用辅材建议，未逐项核验商品页
14 | 供电 | 12V 3A稳压电源适配器 | 3 | 只 | 三节点各1只；低压DC输出，建议5.5×2.1 mm中心正极，配套相同插座。 | 本表选型余量，非原版标定功耗。最终核对警号、传感器和GSM峰值。 | 12V 3A 稳压 电源适配器 5.5 2.1 | HYPERLINK is not implemented. linkLocation=https://search.jd.com/Search?enc=utf-8, friendlyName=京东检索 | HYPERLINK is not implemented. linkLocation=https://s.taobao.com/search friendlyName=淘宝检索 | 京东有12V3A适配器记录 | https://www.jd.com/chanpin/2672192.html
15 | 供电 | LM2596S可调降压模块 | 3 | 块 | 四电气焊孔中心形成约40.005×17.780 mm矩形；输出先调5.0V用于主板。 | 丝印虽写LM2596，实物示例可能是别种降压板。只认孔位和极性；XL4015不能默认直插。 | LM2596S 可调降压 模块 四焊孔 | HYPERLINK is not implemented. linkLocation=https://search.jd.com/Search?enc=utf-8, friendlyName=京东检索 | HYPERLINK is not implemented. linkLocation=https://s.taobao.com/search friendlyName=淘宝检索 | 京东有商品；孔位待确认 | https://www.jd.com/jiage/9855bb3adf062efa6df1.html
16 | 短信条件项 | SIM800L小板 | 1 | 块 | 地面网关用。原板标识一列GND/TX/RX/RST/VCC，针距2.54 mm；需逐脚对应。 | 购买前核实当地SIM卡能注册2G GSM并发短信。大号开发板不视为原位兼容。 | SIM800L 红板 模块 RST VCC GSM | HYPERLINK is not implemented. linkLocation=https://search.jd.com/Search?enc=utf-8, friendlyName=京东检索 | HYPERLINK is not implemented. linkLocation=https://s.taobao.com/search?q=SIM800L%20%E7%BA%A2%E6%9D%BF%20%E6%A8%A1%E5%9D%97%20RST%20VCC%20GSM, friendlyName=淘宝检索 | 京东商品页；未证实该SKU原位兼容 | https://ic-item.jd.com/100079675820.html
17 | 短信条件项 | GSM天线 | 1 | 套 | 匹配所购SIM800L的天线接口；GSM频段天线。 | 若模块已带天线无需重复购买，不能用LoRa天线代替。 | SIM800L GSM 天线 | HYPERLINK is not implemented. linkLocation=https://search.jd.com/Search?keyword=SIM800L%20GSM%20%E5%A4%A9%E7%BA%BF&enc=utf-8, friendlyName=京东检索 | HYPERLINK is not implemented. linkLocation=https://s.taobao.com/search?q=SIM800L%20GSM%20%E5%A4%A9%E7%BA%BF, friendlyName=淘宝检索 | 京东商品含配天线版本 | https://ic-item.jd.com/100079675820.html
18 | 短信条件项 | 可发短信的SIM卡 | 1 | 张 | 卡尺寸匹配SIM800L卡座，并已开通短信、可接入当地2G GSM网络。 | 覆盖和开通状态未核验。仅流量物联网卡不等于可发短信。 | GSM 短信 SIM卡 | HYPERLINK is not implemented. linkLocation=https://search.jd.com/Search?keyword=GSM%20%E7%9F%AD%E4%BF%A1%20SIM%E5%8D%A1&enc=utf-8, friendlyName=京东检索 | HYPERLINK is not implemented. linkLocation=https://s.taobao.com/search?q=GSM%20%E7%9F%AD%E4%BF%A1%20SIM%E5%8D%A1, friendlyName=淘宝检索 | 检索入口，未核验具体商品 | 通用辅材建议，未逐项核验商品页
19 | 短信条件项 | SIM800L独立降压电源 | 1 | 块 | 以裸芯片供电版为前提：可调约4.0V，供电系统可承受2A发射峰值，建议留3A级余量。 | 外接供电。核实小板是否自带稳压，禁止把4V和5V电源并联到同一VCC网络。 | XL4015 可调降压 5A 模块 | HYPERLINK is not implemented. linkLocation=https://search.jd.com/Search?enc=utf-8, friendlyName=京东检索 | HYPERLINK is not implemented. linkLocation=https://s.taobao.com/search friendlyName=淘宝检索 | 京东有XL4015记录；作为外接电源 | https://www.jd.com/jiage/9855bb3adf062efa6df1.html
20 | 短信条件项 | UART电平匹配小板 | 1 | 块 | 选适用于UART推挽信号、3.3V与SIM800L约2.8V逻辑匹配的方案。 | 先核实SIM800L小板已否集成。不要将I2C专用转换模块默认视为验证通过。 | UART 串口 3.3V 2.8V 电平转换 | HYPERLINK is not implemented. linkLocation=https://search.jd.com/Search?enc=utf-8, friendlyName=京东检索 | HYPERLINK is not implemented. linkLocation=https://s.taobao.com/search friendlyName=淘宝检索 | 检索入口，未核验具体商品 | 通用辅材建议，未逐项核验商品页
21 | 接口保护 | 10kΩ 1%电阻 | 10 | 只 | 4路MQ AO各1只上臂电阻，余6只备用；1/4W直插便于小板焊接。 | 用于外加分压，不是原PCB的R1/R2指定值。 | 10K 电阻 1% 1/4W | HYPERLINK is not implemented. linkLocation=https://search.jd.com/Search?keyword=10K%20%E7%94%B5%E9%98%BB%201%25%201%2F4W&enc=utf-8, friendlyName=京东检索 | HYPERLINK is not implemented. linkLocation=https://s.taobao.com/search?q=10K%20%E7%94%B5%E9%98%BB%201%25%201%2F4W, friendlyName=淘宝检索 | 检索入口，未核验具体商品 | 通用辅材建议，未逐项核验商品页
22 | 接口保护 | 15kΩ 1%电阻 | 10 | 只 | 4路MQ AO各1只下臂电阻，余6只备用；5V经10k/15k分压约3.0V。 | 分压接法AO—10k—ADC，ADC—15k—GND。先确认原板有无分压，再接入。 | 15K 电阻 1% 1/4W | HYPERLINK is not implemented. linkLocation=https://search.jd.com/Search?keyword=15K%20%E7%94%B5%E9%98%BB%201%25%201%2F4W&enc=utf-8, friendlyName=京东检索 | HYPERLINK is not implemented. linkLocation=https://s.taobao.com/search?q=15K%20%E7%94%B5%E9%98%BB%201%25%201%2F4W, friendlyName=淘宝检索 | 检索入口，未核验具体商品 | 通用辅材建议，未逐项核验商品页
23 | 接口保护 | 100nF去耦/滤波电容 | 10 | 只 | 4只可用于ADC端对地滤波，1只麦克风近端去耦，其余备用。 | 外接小板按需要装配；增加分压后需重新设传感阈值。 | 100nF 104 独石 电容 | HYPERLINK is not implemented. linkLocation=https://search.jd.com/Search?enc=utf-8, friendlyName=京东检索 (https://search.jd.com/Search?keyword=100nF%20104%20%E7%8B%AC%E7%9F%B3%20%E7%94%B5%E5%AE%B9&enc=utf-8) | HYPERLINK is not implemented. linkLocation=https://s.taobao.com/search?q=100nF%20104%20%E7%8B%AC%E7%9F%B3%20%E7%94%B5%E5%AE%B9, friendlyName=淘宝检索 | 检索入口，未核验具体商品 | 通用辅材建议，未逐项核验商品页
24 | 接口保护 | 10µF去耦电容 | 5 | 只 | 耐压≥10V；麦克风/低压辅助电路局部去耦，含备用。 | 此项为外接辅助器件，不是原PCB C2已确认容量。 | 10uF 16V 电容 | HYPERLINK is not implemented. linkLocation=https://search.jd.com/Search?keyword=10uF%2016V%20%E7%94%B5%E5%AE%B9&enc=utf-8, friendlyName=京东检索 | HYPERLINK is not implemented. linkLocation=https://s.taobao.com/search?q=10uF%2016V%20%E7%94%B5%E5%AE%B9, friendlyName=淘宝检索 | 检索入口，未核验具体商品 | 通用辅材建议，未逐项核验商品页
25 | 短信条件项 | 低ESR储能电容 | 2 | 只 | 暂选470—1000µF、≥10V，GSM电源近端1只加备用1只。 | 为辅助供电建议，不代替电源峰值能力，也不是已确认的原板C2值。 | 1000uF 10V 低ESR 电容 | HYPERLINK is not implemented. linkLocation=https://search.jd.com/Search?keyword=1000uF%2010V%20%E4%BD%8EESR%20%E7%94%B5%E5%AE%B9&enc=utf-8, friendlyName=京东检索 | HYPERLINK is not implemented. linkLocation=https://s.taobao.com/search?q=1000uF%2010V%20%E4%BD%8EESR%20%E7%94%B5%E5%AE%B9, friendlyName=淘宝检索 | 检索入口，未核验具体商品 | 通用辅材建议，未逐项核验商品页
26 | 接插件 | 2.54 mm 1×22排母 | 6 | 条 | 每块主板2条，共6条。 | 配ESP32-S3。井下语音板可选带引出焊点/长脚方案便于飞线，避免双层插座松动。 | 2.54 单排 排母 22P | HYPERLINK is not implemented. linkLocation=https://search.jd.com/Search?keyword=2.54%20%E5%8D%95%E6%8E%92%20%E6%8E%92%E6%AF%8D%2022P&enc=utf-8, friendlyName=京东检索 | HYPERLINK is not implemented. linkLocation=https://s.taobao.com/search?q=2.54%20%E5%8D%95%E6%8E%92%20%E6%8E%92%E6%AF%8D%2022P, friendlyName=淘宝检索 | 检索入口，未核验具体商品 | 通用辅材建议，未逐项核验商品页
27 | 接插件 | 2.54 mm 1×8排母 | 6 | 条 | 每块主板2条，共6条。 | 配Ra-02转接板，注意方向。 | 2.54 单排 排母 8P | HYPERLINK is not implemented. linkLocation=https://search.jd.com/Search?keyword=2.54%20%E5%8D%95%E6%8E%92%20%E6%8E%92%E6%AF%8D%208P&enc=utf-8, friendlyName=京东检索 | HYPERLINK is not implemented. linkLocation=https://s.taobao.com/search?q=2.54%20%E5%8D%95%E6%8E%92%20%E6%8E%92%E6%AF%8D%208P, friendlyName=淘宝检索 | 检索入口，未核验具体商品 | 通用辅材建议，未逐项核验商品页
28 | 接插件 | 2.54 mm 1×40排针/排母 | 4 | 组 | 建议2组排针+2组排母，用于可裁剪接口及备用。 | 已焊针模块不要重复计算模块针。 | 2.54 排针 排母 40P | HYPERLINK is not implemented. linkLocation=https://search.jd.com/Search?keyword=2.54%20%E6%8E%92%E9%92%88%20%E6%8E%92%E6%AF%8D%2040P&enc=utf-8, friendlyName=京东检索 | HYPERLINK is not implemented. linkLocation=https://s.taobao.com/search?q=2.54%20%E6%8E%92%E9%92%88%20%E6%8E%92%E6%AF%8D%2040P, friendlyName=淘宝检索 | 检索入口，未核验具体商品 | 通用辅材建议，未逐项核验商品页
29 | 接插件 | 4P板端座和4芯线 | 5 | 套 | MQ4/MQ7共4套，地面显示1套；本地相应孔距约2.54 mm。 | 优先按2.54 mm规格询价。XH2.54、XH2.5商品命名混乱，须看机械图。针序可重排。 | 2.54 4P 连接器 座 带线 | HYPERLINK is not implemented. linkLocation=https://search.jd.com/Search?enc=utf-8, friendlyName=京东检索 | HYPERLINK is not implemented. linkLocation=https://s.taobao.com/search friendlyName=淘宝检索 | 检索入口，未核验具体商品 | 通用辅材建议，未逐项核验商品页
30 | 接插件 | 3P板端座和3芯线 | 2 | 套 | 两个水位接口，针距2.54 mm。 | 每套含板端座及带端子的线束，按S/+/-重排。 | 2.54 3P 连接器 座 带线 | HYPERLINK is not implemented. linkLocation=https://search.jd.com/Search?enc=utf-8, friendlyName=京东检索 | HYPERLINK is not implemented. linkLocation=https://s.taobao.com/search friendlyName=淘宝检索 | 检索入口，未核验具体商品 | 通用辅材建议，未逐项核验商品页
31 | 接插件 | DC电源插座P1 | 3 | 只 | Gerber显示三孔近似共线，中心距约5.00 mm。接口内径按电源插头配套。 | 不能凭DC-005/DC-022名称下单。先让卖家提供脚位图，或外接带线DC座。 | DC 电源插座 三脚 5.5 2.1 | HYPERLINK is not implemented. linkLocation=https://search.jd.com/Search?enc=utf-8, friendlyName=京东检索 | HYPERLINK is not implemented. linkLocation=https://s.taobao.com/search friendlyName=淘宝检索 | 检索入口，未核验具体商品 | 通用辅材建议，未逐项核验商品页
32 | 接插件 | 6脚双刀开关SWITCH | 3 | 只 | 2×3焊脚，单列相邻孔距2.50 mm，两列中心距5.50 mm。 | 选择保持型电源开关，核实端子额定电流和通断逻辑；与语音瞬时按键不同。 | 6脚 双刀 电源开关 2.5 5.5 | HYPERLINK is not implemented. linkLocation=https://search.jd.com/Search?enc=utf-8, friendlyName=京东检索 | HYPERLINK is not implemented. linkLocation=https://s.taobao.com/search friendlyName=淘宝检索 | 检索入口，未核验具体商品 | 通用辅材建议，未逐项核验商品页
33 | 接插件 | 警号2P接线端子 | 2 | 只 | 本地SIREN两孔中心距6.35 mm。 | 不要默认买5.08 mm端子，若无合适外形可用可靠焊线并做应力固定。 | 接线端子 2P 6.35mm | HYPERLINK is not implemented. linkLocation=https://search.jd.com/Search?keyword=%E6%8E%A5%E7%BA%BF%E7%AB%AF%E5%AD%90%202P%206.35mm&enc=utf-8, friendlyName=京东检索 | HYPERLINK is not implemented. linkLocation=https://s.taobao.com/search?q=%E6%8E%A5%E7%BA%BF%E7%AB%AF%E5%AD%90%202P%206.35mm, friendlyName=淘宝检索 | 检索入口，未核验具体商品 | 通用辅材建议，未逐项核验商品页
34 | 接插件 | 杜邦线和硅胶电源线 | 1 | 批 | 2.54mm公母/母母信号线；电源与警号另用较粗多股线，GSM电源线尽量短。 | 麦克风线尽量短。不要用细杜邦线承载GSM峰值和警号负载。 | 杜邦线 母母 公母 硅胶线 22AWG | HYPERLINK is not implemented. linkLocation=https://search.jd.com/Search?enc=utf-8, friendlyName=京东检索 | HYPERLINK is not implemented. linkLocation=https://s.taobao.com/search friendlyName=淘宝检索 | 检索入口，未核验具体商品 | 通用辅材建议，未逐项核验商品页
35 | 装配 | 2.54 mm洞洞板 | 2 | 块 | 接口分压/按键/电平转换等外接小电路。 | 不改原PCB布线，但新增外接电路需要独立固定。 | 2.54 洞洞板 万能板 | HYPERLINK is not implemented. linkLocation=https://search.jd.com/Search?enc=utf-8, friendlyName=京东检索 | HYPERLINK is not implemented. linkLocation=https://s.taobao.com/search?q=2.54%20%E6%B4%9E%E6%B4%9E%E6%9D%BF%20%E4%B8%87%E8%83%BD%E6%9D%BF, friendlyName=淘宝检索 | 检索入口，未核验具体商品 | 通用辅材建议，未逐项核验商品页
36 | 装配 | 绝缘外壳 | 3 | 只 | 选内尺寸能容纳约99.2×63.0 mm主板及高件，建议从120×90×60 mm内空间询价。 | 尺寸为布置建议。预留USB、天线、传感器通气、麦克风声孔、OLED窗口。 | ABS 电子项目盒 外壳 | HYPERLINK is not implemented. linkLocation=https://search.jd.com/Search?enc=utf-8, friendlyName=京东检索 | HYPERLINK is not implemented. linkLocation=https://s.taobao.com/search friendlyName=淘宝检索 | 检索入口，未核验具体商品 | 通用辅材建议，未逐项核验商品页
37 | 装配 | 绝缘固定件和辅材 | 1 | 批 | 尼龙支撑/PCB卡槽、螺钉螺母、热缩管、扎带、标签、绝缘垫。 | 原板未确认标准M3安装孔，不能直接假定铜柱穿板可用；按外壳固定结构购买。 | PCB 卡槽 支架 尼龙 支撑 热缩管 | HYPERLINK is not implemented. linkLocation=https://search.jd.com/Search?enc=utf-8, friendlyName=京东检索 | HYPERLINK is not implemented. linkLocation=https://s.taobao.com/search friendlyName=淘宝检索 | 检索入口，未核验具体商品 | 通用辅材建议，未逐项核验商品页
38 | 调试 | USB数据线 | 3 | 根 | 匹配所选开发板接口，可传数据。 | USB与外部电源同时使用前确认开发板电源隔离，避免回灌。 | Type C USB 数据线 | HYPERLINK is not implemented. linkLocation=https://search.jd.com/Search?keyword=Type%20C%20USB%20%E6%95%B0%E6%8D%AE%E7%BA%BF&enc=utf-8, friendlyName=京东检索 | HYPERLINK is not implemented. linkLocation=https://s.taobao.com/search?q=Type%20C%20USB%20%E6%95%B0%E6%8D%AE%E7%BA%BF, friendlyName=淘宝检索 | 检索入口，未核验具体商品 | 通用辅材建议，未逐项核验商品页
39 | 待定原位 | Q1三极管 | 2 | 只 | 井下驱动位每板1只。外形类似TO-92，型号和E/B/C网络未确认。 | 暂停按型号购买；Gerber丝印不能推断S8050、2N2222或其引脚排列。 | 待原理图确认型号 | 待定型号 | 待定型号 | 缺原理图/BOM，不可按占位词采购 | https://github.com/SanchilaAmavi/mine-safety-system
40 | 待定原位 | Q2功率管 | 2 | 只 | 井下驱动位每板1只。外形类似TO-220，孔距2.54 mm；器件类型/型号未确认。 | 先确定栅极/源极/漏极网络、极性及驱动电压，不能直接指定IRF540或IRLZ44N。 | 待原理图确认型号 | 待定型号 | 待定型号 | 缺原理图/BOM，不可按占位词采购 | https://github.com/SanchilaAmavi/mine-safety-system
41 | 待定原位 | R1、R2驱动电阻 | 4 | 只 | 两个井下板各R1/R2一只，共4只。阻值、功率及装配方式未确认。 | 不可拿外接分压的10k/15k直接代替。 | 待原理图确认阻值 | 待定型号 | 待定型号 | 缺原理图/BOM，不可按占位词采购 | https://github.com/SanchilaAmavi/mine-safety-system
42 | 待定原位 | D1二极管 | 2 | 只 | 井下板各1只。封装、极性、用途及耐压电流均待确认。 | 不能仅凭D1假定是1N4007、SS34或稳压二极管。 | 待原理图确认二极管 | 待定型号 | 待定型号 | 缺原理图/BOM，不可按占位词采购 | https://github.com/SanchilaAmavi/mine-safety-system
43 | 待定原位 | C2电解电容 | 3 | 只 | 每板1个位置，孔中心距5.08 mm。容量、耐压和所在电源网络未确认。 | 若在12V轨，16V仅是耐压起点，优先核对原设计。不要把GSM近端电容默认焊此处。 | 待原理图确认 C2 5.08 | 待定型号 | 待定型号 | 缺原理图/BOM，不可按占位词采购 | https://github.com/SanchilaAmavi/mine-safety-system
44 | 备选外接 | 3.3V触发MOS开关模块 | 2 | 块 | 仅在无法确定原驱动级时作为外接替代路径，控制12V警号，支持高电平触发。 | 与Q1/Q2/R1/R2/D1原位装配二选一。须验证GPIO18触发和断电状态，不算原位兼容。 | MOS 开关模块 3.3V 触发 12V | HYPERLINK is not implemented. linkLocation=https://search.jd.com/Search?enc=utf-8, friendlyName=京东检索 | HYPERLINK is not implemented. linkLocation=https://s.taobao.com/search friendlyName=淘宝检索 | 京东有同类记录；控制门限待核 | https://www.jd.com/chanpin/3111473.html
45 | 备件 | 关键模块备件 | 1 | 批 | 可另备ESP32-S3×1、Ra-02+底板+天线×1、INMP441×1。 | 选配，未计入上方装机数量。已有可用硬件按实际抵扣，文件存在不等于实物已持有。 | ESP32 S3 N16R8 Ra02 INMP441 | HYPERLINK is not implemented. linkLocation=https://search.jd.com/Search?keyword=ESP32%20S3%20N16R8%20Ra02%20INMP441&enc=utf-8, friendlyName=京东检索 | HYPERLINK is not implemented. linkLocation=https://s.taobao.com/search?q=ESP32%20S3%20N16R8%20Ra02%20INMP441, friendlyName=淘宝检索 | 检索入口，未核验具体商品 | 通用辅材建议，未逐项核验商品页
46 | 工具 | 万用表及焊接工具 | 1 | 套 | 万用表、恒温焊台、焊锡/助焊剂、吸锡带、镊子、剥线钳。 | 已有可借用。上电前测各电源轨电压和对地短路。 | 数字万用表 恒温焊台 焊接工具 | HYPERLINK is not implemented. linkLocation=https://search.jd.com/Search?enc=utf-8, friendlyName=京东检索 | HYPERLINK is not implemented. linkLocation=https://s.taobao.com/search friendlyName=淘宝检索 | 检索入口，未核验具体商品 | 通用辅材建议，未逐项核验商品页
47 | 演示已有 | 电脑、手机和2.4GHz网络 | 1 | 套 | 训练/烧录电脑、App演示手机，可用手机热点；断网演示本身不需路由器。 | 默认复用。离线关键词识别不需树莓派、摄像头、功放或语音播放扬声器。 | 2.4GHz WiFi 路由器 | HYPERLINK is not implemented. linkLocation=https://search.jd.com/Search?keyword=2.4GHz%20WiFi%20%E8%B7%AF%E7%94%B1%E5%99%A8&enc=utf-8, friendlyName=京东检索 | HYPERLINK is not implemented. linkLocation=https://s.taobao.com/search?q=2.4GHz%20WiFi%20%E8%B7%AF%E7%94%B1%E5%99%A8, friendlyName=淘宝检索 | 检索入口，未核验具体商品 | 通用辅材建议，未逐项核验商品页

Sheet: PCB核对
PCB尺寸、装配边界与接线核对
尺寸为本地Gerber坐标计算；有孔位证据不等于已经验证电气网络。
原仓库：https://github.com/SanchilaAmavi/mine-safety-system
优先向卖家确认开发板、LoRa底板、降压板和接插件，避免同名不同封装。
核对项目 | 规格或结论 | 具体说明 | 依据
方案基线 | 9月9日离线语音方案 | 两套井下节点+一套地面网关。只给井下节点1增加INMP441和瞬时按键。 | 本地最新方案及build_competition_plan.py
核验范围 | 尚非逐器件定版BOM | 本次已核对原仓库、固件、实物照片和Gerber钻孔。无完整原理图/BOM，未做实板通断或全网表还原。 | GitHub README和本地Gerber
采购证据 | 商品记录不等于库存确认 | 京东主要模块查到商品页或集合记录；链接未证明具体SKU的尺寸、电气兼容或收货地库存。淘宝仅提供检索入口。 | 2026-09-11检索
PCB外形 | 99.187 × 62.992 mm | 板框X=9.271至108.458，Y=-35.052至27.940。板厚和铜厚未从Gerber证实。 | Gerber_BoardOutlineLayer.GKO
ESP32插座 | 2×22；2.54 mm；排距25.40 mm | 两排Y=19.431和-5.969。每排X=52.832至106.172。要求完整开发板按此针序布置。 | Drill_PTH_Through.DRL，T03
ESP32针序 | 从天线端到USB端核对 | 3V3侧：3V3,3V3,RST,4,5,6,7,15,16,17,18,8,3,46,9,10,11,12,13,14,5V,GND。另一侧：GND,TX,RX,1,2,42,41,40,39,38,37,36,35,0,45,48,47,21,20,19,GND,GND。 | Gerber_TopSilkscreenLayer.GTO和原板照片
LoRa底板 | 2×8；2.54 mm；排距25.40 mm | 两列X=73.787和99.187；Y=-12.954至-30.734。必须带转接板，针序另核。 | Drill_PTH_Through.DRL，T04
降压板 | 焊孔矩形40.005 × 17.780 mm | X=25.273/65.278，Y=-13.081/-30.861；按丝印IN+/IN-/OUT+/OUT-核对。孔位不是板外形尺寸。 | Drill_PTH_Through.DRL，T04
警号端子 | 6.35 mm | X=22.860和29.210，Y=22.733。可按孔距买端子，外形仍需匹配。 | Drill_PTH_Through.DRL，T09
电源开关 | 单列2.50 mm；两列5.50 mm | 2×3脚。X=11.982/17.482，Y=-31.202/-28.702/-26.202；检查开关内部连接。 | Drill_PTH_Through.DRL，T05
P1/C2 | P1约5.00 mm；C2为5.08 mm | P1三孔近共线；C2两孔X=37.719/42.799。仅能约束机械尺寸，不能给出DC座具体型号或电容值。 | Drill_PTH_Through.DRL，T10/T05
原驱动级 | Q1/Q2/R1/R2/D1待定 | 严格原位装配需要作者的原理图或BOM；外接MOS驱动是另外一条实现路径，不能冒称原版元件。 | 原板丝印和assembled pcb.jpg
电源路径 | 12V、5V、3.3V、约4V分开 | 12V供警号，主降压5V供ESP32开发板及适配的MQ模块，Ra-02/INMP441用3.3V。SIM800L按小板说明独立供电。 | 原方案；安信可Ra-02；SIMCom供电文档
模拟输入保护 | 四路MQ AO先核电压 | 10k上臂+15k下臂使5V约变3.0V；需外接改线且重新标定阈值。若原板已有合适分压不叠加。5V供电水位模块也须同样核验输出上限。 | 原固件GPIO4/5/6为ADC输入；工程补充选型
语音飞线建议 | GPIO15/16/17及GPIO7 | 候选映射：SCK=15，WS=16，SD=17，按键=7。仅根据现有井下固件未占用提出，须测原板网络后确定；LR接GND选单声道。 | underground_node1_mine1.ino；INMP441模块引脚需实物核对
已占用引脚 | LoRa与传感器保持一致 | LoRa NSS10/MOSI11/SCK12/MISO13/RST14/DIO0=9；井下MQ4=4/MQ7=5/水位6/警号18；地面OLED5/6、蜂鸣器8、GSM47/48/19。 | 本地firmware的两个节点文件
地面USB冲突 | GSM_RST=19需核对 | ESP32-S3 GPIO19涉及原生USB D-，如使用原生USB口需检查冲突，优先用独立USB-UART口调试。GPIO35/36/37也不作为N16R8语音接线默认选择。 | 现有固件；ESP32-S3开发板资料
SIM800L使用条件 | 网络及供电均待验证 | 裸SIM800L典型供电3.4—4.4V、推荐4.0V并有约2A脉冲需求。成品小板可能自带稳压。2G注册/短信能力须在比赛地点实测。 | SIMCom SIM800H&SIM800L Hardware Design V2.02
MQ-7局限 | 演示阈值不能当可靠ppm | 实际气敏元件的加热周期按厂家型号资料实施。MQ-7B资料给出高温60秒、低温90秒，不能默认所有廉价模块已实现。 | https://www.winsen-sensor.com/product/mq-7b.html?trk=public_post-text
采购范围 | 教学和竞赛原型 | 沿用最新方案的实验室用途；本清单不构成真实矿井使用的认证设备选型。 | 最新本地方案第八节
向卖家发送 | 开发板机械核对 | 请确认ESP32-S3 N16R8是44针双USB板，每排22针、间距2.54mm、两排中心距25.40mm，并发正反面高清图及尺寸图。 | 可复制询价文本
向卖家发送 | LoRa和电源板机械核对 | 请确认Ra-02带16针转接板，每侧8针、两排中心距25.40mm；降压板四焊孔中心矩形40.005×17.780mm，并提供引脚图。 | 可复制询价文本
