azeedanhilmiya-eng/mine-safety-system/firmware/esp32s3-kws/src/web_assets.h

#pragma once

#include <Arduino.h>

static const uint8_t INDEX_HTML_GZ[] PROGMEM = {
  0x1f, 0x8b, 0x08, 0x00, 0x00, 0x00, 0x00, 0x00, 0x02, 0xff, 0xd5, 0x3d, 0x6b, 0x97, 0x13, 0xc7,
  0x95, 0xdf, 0x73, 0x4e, 0xfe, 0x43, 0x45, 0x1c, 0xc7, 0x8c, 0x57, 0x2d, 0xb5, 0x5a, 0x8f, 0xd1,
  0xcc, 0x30, 0xb3, 0x06, 0xec, 0xc4, 0xde, 0x13, 0x62, 0x62, 0x88, 0xb3, 0xf9, 0xd8, 0x92, 0x5a,
  0xa3, 0x36, 0x2d, 0xb5, 0xb6, 0xbb, 0x35, 0xcc, 0x98, 0xc3, 0x39, 0x63, 0x1b, 0xdb, 0x60, 0x30,
  0x8f, 0x18, 0x3b, 0x09, 0x26, 0x21, 0xc4, 0xc1, 0x10, 0xef, 0x1a, 0x88, 0xb1, 0x0d, 0x01, 0x13,
  0xce, 0xd9, 0x9f, 0xc2, 0x22, 0x69, 0xf8, 0xe4, 0xfc, 0x84, 0xbd, 0xf5, 0xe8, 0xee, 0xaa, 0xee,
  0xea, 0x56, 0x6b, 0x66, 0x60, 0xbd, 0x98, 0x19, 0xa4, 0xee, 0xaa, 0x5b, 0xf7, 0xde, 0xba, 0xef,
  0x7a, 0x78, 0xd7, 0x8f, 0x5e, 0x78, 0x65, 0xef, 0xc1, 0x5f, 0xef, 0x7f, 0x11, 0x75, 0xbc, 0xae,
  0xb5, 0xf4, 0xc3, 0x1f, 0xec, 0xc2, 0xff, 0x22, 0x4b, 0xef, 0x2d, 0x2f, 0xe6, 0xde, 0xe8, 0x28,
  0x7b, 0x7f, 0x9e, 0x23, 0x0f, 0x0d, 0xbd, 0x05, 0xff, 0x22, 0xb4, 0xab, 0x6b, 0x78, 0x3a, 0x6a,
  0x76, 0x74, 0xc7, 0x35, 0xbc, 0xc5, 0xdc, 0x2f, 0x0f, 0xfe, 0x44, 0xa9, 0xe7, 0x50, 0x91, 0x7b,
  0xd7, 0xd3, 0xbb, 0xc6, 0x62, 0x6e, 0xc5, 0x34, 0x0e, 0xf7, 0x6d, 0xc7, 0xcb, 0xa1, 0xa6, 0xdd,
  0xf3, 0x8c, 0x1e, 0xb4, 0x3d, 0x6c, 0xb6, 0xbc, 0xce, 0x62, 0xcb, 0x58, 0x31, 0x9b, 0x86, 0x42,
  0xbe, 0xe4, 0x91, 0xd9, 0x33, 0x3d, 0x53, 0xb7, 0x14, 0xb7, 0xa9, 0x5b, 0xc6, 0x62, 0xa9, 0xa0,
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
  0x65, 0x24, 0x98, 0xa4, 0xcf, 0xf8, 0xc8, 0xc8, 0x81, 0xb2, 0x3a, 0xfc, 0x58, 0x4c, 0x72, 0x56,
  0x02, 0x14, 0x82, 0xba, 0x9e, 0xcc, 0xf2, 0x6f, 0xff, 0xa0, 0x00, 0xf8, 0x18, 0x0f, 0xfa, 0x24,
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
};
static const size_t FAVICON_JPEG_GZ_LEN = sizeof(FAVICON_JPEG_GZ);
