azeedanhilmiya-eng/mine-safety-system/firmware/surface_node/include/onenet_ca.h

#pragma once
// DigiCert Global Root G2, trusted root for open.iot.10086.cn as observed 2026-09-28.
static const char ONENET_ROOT_CA[] = R"PEM(
-----BEGIN CERTIFICATE-----
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
MrY=
-----END CERTIFICATE-----
)PEM";
