azeedanhilmiya-eng/mine-safety-system/firmware/surface_node/include/onenet_secrets.example.h

#pragma once

// Copy to onenet_secrets.h and keep that file out of version control.
static const char *WIFI_SSID = "YOUR_WIFI_SSID";
static const char *WIFI_PASSWORD = "YOUR_WIFI_PASSWORD";
static const char *ONENET_PRODUCT_ID = "YOUR_PRODUCT_ID";
static const char *ONENET_DEVICE_NAME = "YOUR_DEVICE_NAME";
static const char *ONENET_DEVICE_TOKEN = "YOUR_DEVICE_TOKEN";
