azeedanhilmiya-eng/mine-safety-system/(commit log)

2026-09-17 Add offline keyword-spotting model pipeline and voice node firmware
    Adds the training-to-deployment path for the underground voice node: a 4-class
    INT8 keyword spotter (silence / unknown / help / evacuate) for the ESP32-S3,
    reporting through the existing LoRa link.
    The pipeline is built around one constraint: the board must see exactly the
    features the model trained on. Training features come from TensorFlow's
    audio_microfrontend, which is the same C source tflite-micro compiles into the
    firmware, so the two sides share an implementation rather than two descriptions
    of one. Every shared parameter has a single home in kws/config.py, and
    kws_config.h is generated from it.
    Model: DS-CNN, 23,8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
2026-09-17 Evaluate the model under the firmware's decision rule, not a proxy for it
    evaluate.py scored single-window argmax while the board votes across three
    overlapping windows and reports the highest confidence among the windows that
    agreed. That confidence is never below a single window's, so a threshold picked
    on single windows is looser on the device than its own numbers claim, and the
    reported false-trigger rate understated what the board would do. The docstring
    on apply_threshold asserted the two rules matched; they never did.
    evaluate.py now places each test clip at a random offset inside a simulated
    push-to-talk capture -- the timing gap between pressing the button and speaking
    is exactly w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
    [export_test_vectors.py]
2026-09-17 Handle voice events on the surface gateway
    processPacket() parses telemetry by position, so a voice packet reaching it was
    either dropped as an unknown node id or, with the node id first, had its
    sequence number read as a hazard flag and raised an alarm nobody called in.
    Voice events are now taken before that parse.
    The packet format moves into kws_packet.h, header-only and free of Arduino
    types, compiled by both the node and the gateway. A format implemented once per
    end is a format that drifts. Parsing is strict: field count, ranges and
    checksum shape are all refused rather than guessed at, and a host test checks
    that every single-character mutation of a valid packet is rejected -- a radi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
    [Arduino.h]
2026-09-23 地面网关: 新增 surface_node_vscode 工程(LoRa 收包解析/在线离线与报警状态机/OLED 中文显示/Firebase 上报/下行回执 ACK 连发); 一并收录 voice_node_vscode
    [partitions.csv]
2026-09-28 Add offline voice node firmware to main repo
    [esp_sr_16.csv, partitions_esp_sr_16_custom.csv]
2026-09-28 Add project and hardware documentation
    [最新方案_硬件采购与PCB核对清单.xlsx]
