azeedanhilmiya-eng/mine-safety-system/(notices)

Notices in the files:
README.md:
License: MIT
